luandersonarlindo/IrrigacaoInteligente/irrigation_controller.h

#pragma once

// ============================================================
//  irrigation_controller.h — Controlador de Irrigação
//
//  Fase 2: GPIO reais, trigger HIGH, timeout de segurança.
//
//  Responsabilidade: acionar/desacionar relés e monitorar
//  tempo de segurança no modo manual.
//  NÃO conhece menu, NÃO conhece display.
// ============================================================

#include <Arduino.h>
#include "Config.h"
#include "runtime_config_manager.h"

enum class EstadoValvula
{
    FECHADA,
    ABERTA
};

// Conta quantos bits (setores) estão marcados em uma máscara. Usado por
// DisplayManager e WebApManager para resumir quantos setores estão em cada
// estado (abertos, em agenda, selecionados etc.).
inline int contarBitsSetor(uint16_t mask)
{
    int total = 0;
    for (int i = 0; i < NUM_VALVULAS; i++)
    {
        if (mask & (1U << i))
            total++;
    }
    return total;
}

class IrrigationController
{
public:
    explicit IrrigationController(RuntimeConfigManager &config);

    void begin();

    // Toggle: se fechada abre, se aberta fecha
    // Retorna o novo estado após o toggle
    EstadoValvula toggleValvula(int indice);

    // Aciona por agendamento por um período em minutos.
    // Se a válvula já estiver aberta, preserva o maior tempo restante.
    void iniciarAgendamento(int indice, uint16_t duracaoMin);

    // Fecha uma válvula específica
    void fecharValvula(int indice);

    // Fecha todas — segurança garantida
    void fecharTodas();

    // Retorna o estado atual de uma válvula
    EstadoValvula estadoValvula(int indice) const;

    // Retorna true se alguma válvula está aberta
    bool algumAbertas() const;

    // Origem da válvula aberta: false = manual, true = agendamento automático.
    bool valvulaEmAgendamento(int indice) const;

    // Quantas válvulas estão abertas por origem manual (não-agendamento).
    int contarAbertasManual() const;

    // Quantas válvulas estão abertas por origem de agendamento automático.
    int contarAbertasAutomatico() const;

    // Tempo restante até o fechamento automático (0 se fechada ou vencida)
    unsigned long tempoRestanteMs(int indice) const;

    // Deve ser chamado no loop() — verifica timeout de segurança
    // Retorna índice da válvula que foi fechada por timeout, -1 se nenhuma
    int atualizar();

private:
    RuntimeConfigManager &_config;
    EstadoValvula _estados[NUM_VALVULAS];
    unsigned long _tempoAbertura[NUM_VALVULAS]; // millis() de quando abriu
    unsigned long _deadlineFechamento[NUM_VALVULAS];
    bool _origemManual[NUM_VALVULAS];

    // Mapa de pinos — índice 0 = canal 1
    static const uint8_t _pinos[NUM_VALVULAS];

    void abrirValvula(int indice);
    void atualizarDeadline(int indice, unsigned long novoDeadline, bool origemManual);
    bool indiceValido(int indice) const;
};
