luandersonarlindo/IrrigacaoInteligente/display_manager.h

#pragma once

// ============================================================
//  display_manager.h — Gerenciador de Display
//
//  Responsabilidade: decidir O QUE mostrar no display.
//  Consulta o MenuController para saber o estado atual.
//  Usa o DisplayDriverOled para saber COMO mostrar.
//
//  Separação clara:
//    Driver  = como desenhar (hardware)
//    Manager = o que desenhar (lógica de UI)
// ============================================================

#include <Arduino.h>
#include "Config.h"
#include "display_driver_oled.h"
#include "menu_controller.h"
#include "menu_cards.h"
#include "rtc_driver_ds3231.h"
#include "dht11_driver.h"
#include "irrigation_controller.h"
#include "web_ap_manager.h"

class DisplayManager
{
public:
    DisplayManager(DisplayDriverOled &display,
                   MenuController &menu,
                   RtcDriverDs3231 &rtc,
                   IrrigationController &irrigacao,
                   WebApManager &webAp,
                   Dht11Driver &dht11);

    void begin();

    // Estado da execução sequencial de agenda (lotes + intervalo).
    void atualizarEstadoAgendaSequencial(bool ativa,
                                         bool aguardandoIntervalo,
                                         uint8_t setoresEmLote,
                                         uint8_t setoresPendentes,
                                         uint16_t setoresLoteMask,
                                         uint16_t setoresPendentesMask);

    // Deve ser chamado no loop() — renderiza a tela correta
    void atualizar();

private:
    DisplayDriverOled &_display;
    MenuController &_menu;
    RtcDriverDs3231 &_rtc;
    Dht11Driver &_dht11;
    IrrigationController &_irrigacao;
    WebApManager &_webAp;

    // Telas
    void desenharMenuPrincipal();
    void desenharTelaStatus();
    void desenharTelaSensores();
    void desenharTelaIrrigacao();
    void desenharTelaProgramar();
    void desenharTelaConfig();
    void desenharTelaWebServer();

    // Componentes reutilizáveis
    void desenharCabecalho(const char *titulo);
    void desenharCursor(int y);
    // Rodapé padrão: linha separadora em y=54 + texto de dica em y=56
    void desenharRodapeDica(const char *texto);
    // Par de botões SIM/NAO com destaque no selecionado (opcaoSelecionada: 0=SIM, 1=NAO)
    void desenharConfirmacaoSimNao(int opcaoSelecionada);
    // Cards empilhados (estilo Menu Principal) com contador "N/total" no rodapé,
    // usados pelos submenus de Configurações. iconeAtual é um bitmap 1bpp 28x28
    // (ex: ICON_CLOCK_28X28); a opção "Voltar" usa ICON_CORNER_UP_LEFT_28X28.
    void desenharCardsOpcao(const char *rotuloAtual, const char *rotuloProximo,
                             const uint8_t *iconeAtual, int posicaoAtual, int totalOpcoes);

    // Controle de atualização (evita redesenho desnecessário)
    unsigned long _ultimaAtualizacao;
    static const unsigned long INTERVALO_ATUALIZACAO_MS = 200;

    // Apaga o painel após inatividade no dashboard (Status, sem menu ativo)
    bool _displayLigado;
    static const unsigned long DASHBOARD_TIMEOUT_MS = 60000;

    // Estado operacional da agenda automática sequencial
    bool _agendaExecucaoAtiva;
    bool _agendaAguardandoIntervalo;
    uint8_t _agendaSetoresEmLote;
    uint8_t _agendaSetoresPendentes;
    uint16_t _agendaSetoresLoteMask;
    uint16_t _agendaSetoresPendentesMask;
};
