luandersonarlindo/IrrigacaoInteligente/(commit log)

2026-04-11 Atualiza README.md com descrição detalhada do projeto, objetivos, arquitetura, funcionalidades e instruções de uso.
2026-04-11 Adiciona suporte à configuração de data e hora no MenuController e atualiza dependências no IrrigacaoInteligente
2026-04-11 Adiciona gerenciador de configuração em tempo de execução, integrando novas funcionalidades ao MenuController, ScheduleManager e IrrigationController. Atualiza a lógica de configuração e armazenament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
2026-04-11 Adiciona funcionalidade de restauração de configurações padrão e implementa teste de válvulas no MenuController. Atualiza o DisplayManager para exibir novas opções de configuração e ajusta a lógica d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
2026-04-11 Adiciona opção de voltar no MenuController e atualiza lógica de navegação. Melhora exibição no DisplayManager para incluir item Voltar e ajusta lógica de timeout.
2026-04-11 Atualiza README.md e guia didático com informações sobre o sistema de irrigação, arquitetura, fluxo de execução e mapeamento de pinos. Melhora a clareza e a organização do conteúdo.
2026-04-11 Adiciona opção "Voltar" ao submenu de programação e ajusta a lógica de navegação no MenuController. Atualiza o DisplayManager para exibir corretamente as opções de setores e a nova opção de voltar.
2026-04-12 feat: Implementar novos ícones de status e atualizar a tela de status
    - Adicionadas funções para desenhar ícones de status de irrigação, válvula, agenda e relógio no display.
    - Atualizada a função `desenharTelaStatus` para incluir informações sobre o estado da irrigação e a próxima agenda.
    - Implementada a lógica para determinar se uma válvula está em agendamento automático.
    - Adicionadas variáveis de estado para gerenciar a execução da agenda sequencial.
    - Atualizada a classe `MenuController` para incluir a verificação de eventos de exclusão de agenda.
    - Implementada a função `obterProximaExecucao` na classe `ScheduleManager` para localizar a próxima execução v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
2026-04-12 Atualiza formatação da tabela de mapeamento de pinos no README.md para melhor legibilidade.
2026-04-12 refactor: altera tipo de _ultimaChaveMinuto para int32_t e ajusta lógica de execução de agendas
2026-04-12 refactor: desabilita mensagens de debug no monitor serial e ajusta formatação de textos no WebApManager feat: adiciona ícone de Wi-Fi e atualiza lógica de navegação no MenuController
2026-04-12 refactor: reorganiza seções do README.md para melhor clareza e adiciona instruções de configuração rápida
2026-04-12 feat: adiciona ícones para o dashboard da irrigação e corrige formatação do HTML
2026-04-12 feat: adiciona suporte à paginação manual no WebServer e melhora a exibição de informações
2026-04-13 refactor: adiciona emojis para melhorar a legibilidade e organização do README.md, FASE5_CONTRATO_TECNICO.md e GUIA_DIDATICO_PROJETO.md
2026-04-13 feat: atualiza credenciais de Wi-Fi para nova rede
2026-04-16 Add event logging functionality to web_ap_manager
    - Introduced a new structure `EventoSistema` to store event details.
    - Added a maximum event history size constant `MAX_HISTORICO_EVENTOS`.
    - Implemented member variables for managing event history, including count and head index.
    - Added methods for initializing monitoring, updating event history, registering events, sending alerts, and clearing event history.
    - Included utility functions for counting open valves and escaping JSON strings.
2026-04-17 feat: Implementa painel de notificações no WebApManager
2026-04-18 feat: atualiza datas de revisão e adiciona novas funcionalidades ao contrato técnico e guias didáticos
2026-04-18 feat: adiciona suporte a configurações privadas e otimiza gerenciamento de agenda
2026-04-19 feat: adiciona suporte a mDNS para acesso ao sistema via hostname
2026-04-19 feat: adiciona suporte a WebSocket para comunicação em tempo real
2026-04-19 feat: adiciona badge de status para WebSocket com atualização dinâmica
2026-05-07 feat: adiciona suporte ao sensor DHT11 com leitura de temperatura e umidade
2026-07-15 feat(test): configure native PlatformIO test harness
    Task 1.1: Configurar ambiente PlatformIO nativo para testes
    TDD: RED > GREEN > REFACTOR complete
2026-07-15 test(schedule): extract and cover agenda validation rules
    Task 1.2: Isolar e testar regras de validação de agenda
    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
2026-07-15 chore: close Phase 1 (Fundação de Testes)
2026-07-15 test(schedule): extract and cover version+CRC validation for NVS blocks
    Task 2.1: Testar validação de versão+CRC do banco de agendas
    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
2026-07-15 test(execution): extract and cover batch selection and duration-conflict rules
    Task 2.2: Testar motor de execução sequencial por lotes (escopo parcial:
    seleção de lote + regra de conflito de duração). Retomada de janela ativa
    com tempo remanescente adiada para Task 2.3 (maior escopo, ~150 linhas de
    aritmética de época em schedule_manager.cpp, sem toolchain ESP32 disponível
    neste ambiente para validar).
    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
2026-07-16 feat(display): add sensor history graph and fix structural review findings
    Adiciona mini-gráfico de temperatura (últimas ~4h) na tela Sensores,
    com buffer circular testado em SensorHistorico. Corrige bugs achados
    em revisão estrutural completa: escala do eixo X do gráfico, checagem
    de agenda já executada em obterProximaExecucao, e bounds check em
    SensorHistorico::obter. Elimina duplicação de código (contagem de
    válvulas, popcount de bitmask, desenho de rodapé) e extrai a máquina
    de estados de execução de agenda do main.ino para AgendaExecutor
    dedicado, usando bitmask em vez de bool[8].
    [Config.h, IrrigacaoInteligente.ino, agenda_executor.cpp, agenda_executor.h, dht11_driver.cpp, dht11_driver.h, display_manager.cpp, display_manager.h]
2026-07-16 feat(display): redesign menu principal as stacked cards
    [display_manager.cpp, display_manager.h]
2026-07-16 fix(display): stop selected menu label from overflowing into OK arrow
    desenharMenuPrincipal() drew the selected item's label with
    desenharTextoGrande (10px/char, u8g2_font_10x20_tf) starting at x=40,
    which overflows the 128px display or collides with the OK arrow at
    x=118 for every menu item (e.g. "Irrigar Agora"/"Configuracoes" need
    130px, "Programar"/"WEBSERVER" need 90px, "Sensores" needs 80px).
    Switch to desenharTexto (6px/char, u8g2_font_6x10_tf), matching the
    font already used for the bottom card and most other screens. At
    6px/char the longest labels (13 chars) need exactly 78px, ending at
    x=118 with zero overlap. Adjusted the y-offset from cardSelY+8 to
    cardSelY+12 to keep the shorte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
    [display_manager.cpp]
2026-07-16 feat(display): apply stacked-cards style to Config submenus
    Extends the Pirx-style 2-card layout (selected item large + next item
    dimmed, circular wrap via MenuCards::proximoIndice) from Menu Principal
    to the 3 Config submenus (MENU, SUBMENU_RELOGIO, SUBMENU_SISTEMA),
    replacing the old 4-line sliding window.
    New DisplayManager::desenharCardsOpcao helper adds a "N/total" counter
    in the footer, since these submenus have up to 8 options (vs 5 fixed
    in Menu Principal) and lose the at-a-glance list depth the sliding
    window gave. Icons stay at their existing 8x8 size (redrawing at 32x32
    like Menu Principal was out of scope).
    [display_manager.cpp, display_manager.h]
2026-07-16 fix(display): remove header and enlarge icons on Config cards
    Hardware photos showed the "CONFIGURACOES"/"CONFIG > RELOGIO"/
    "CONFIG > SISTEMA" header overlapping the card border, and the 8x8
    icons were nearly illegible at that size.
    Removed desenharCabecalho() from the 3 option-card blocks (feedback
    animation screens keep their header, untouched). Replaced the 8x8
    icons with 28x28 1bpp bitmaps rasterized from real Lucide icons
    (lucide.dev, ISC license) via unpkg + @resvg/resvg-js, matching the
    icon scale used on Menu Principal. desenharCardsOpcao now takes a
    const uint8_t* bitmap instead of an int index; desenharIconeOuVoltar
    is gone since "Voltar" is now just the corner-up-left bitmap lik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
    [display_manager.cpp, display_manager.h]
2026-07-16 feat(display): extend Lucide icon cards to Editar Agenda, drop feedback animations
    Migrate EtapaProgramacao::SUBMENU_AGENDA (Programar > Editar Agenda) to
    the same desenharCardsOpcao stacked-card pattern already used by the
    Config submenus, reusing the existing Lucide 28x28 icon set. The old
    8x8 desenharIconeSubmenu (only caller left) is removed.
    Replace the frame-based feedback animations (check48/lixeira48, ~110
    lines of per-tick geometry) with a single desenharFeedbackIcone helper
    that shows a static 28x28 Lucide icon for a fixed 1200ms instead of
    animating over ~2s. Used across all 4 feedback points (Programar
    saved/deleted, Config saved/cleared/restored) — less flash, simpler
    logic,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
    [display_manager.cpp, menu_controller.cpp]
2026-07-16 feat(display): redesign Status dashboard header with WiFi indicator
    Remove the "ON N/N" text + tap icon from the top-right corner of the
    dashboard header — it was redundant with the sector status line right
    below it (e.g. "MANUAL S1/8"), and freed up space for something more
    useful.
    Replace it with a WiFi connectivity icon (Lucide wifi/wifi-off, 12x12)
    driven by the already-existing WebApManager::staConectada() — no new
    API needed. Only 2 states (connected/not), no RSSI, since signal
    strength isn't reliably meaningful on this ESP32's combined AP+STA
    setup.
    Also swap the small hand-drawn clock and next-agenda icons (10x10)
    for their Lucide equivalents (clock, calendar-clock) at 14x14, t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
    [display_manager.cpp]
2026-07-16 fix(display): fine-tune Status dashboard after hardware validation
    Three adjustments based on physical display photos:
    - Swap the WiFi icon from "wifi" (4 concentric arcs) to Lucide's
    "wifi-high" (3 arcs) — the extra outer arc was cluttered and hard
    to read at 12x12.
    - Drop the "S%d/%d" sector count from the MANUAL/AUTO/ATIVO status
    line (now just "MANUAL", "AUTO", "MANUAL + AUTO", "ATIVO") — the
    count is already redundant with the per-sector web dashboard.
    - Remove the "Gire para abrir menu" footer and expand the "Próxima
    Agenda" box from 20px to 35px tall (down to the display's exact
    bottom edge), giving the calendar icon and its two text lines
    room to breathe instead o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
    [display_manager.cpp]
2026-07-17 fix(display): revert WiFi icon and add dashboard idle screensaver
    Revert the WiFi icon back to the original 4-arc "wifi" glyph — the
    prior swap to "wifi-high" (3 arcs) had it backwards from what was
    actually intended on hardware.
    Add a screensaver for the dashboard: after 60s with no encoder
    interaction while parked on the Status screen (not navigating any
    menu), the OLED panel powers down via U8g2's setPowerSave — an I2C
    command, not a physical power cut — and wakes back up on the next
    rotation or click.
    MenuController gets a new msDesdeUltimaInteracao() getter that
    reuses the existing _ultimoEventoMenuMs timestamp (already tracked
    for the pre-existing 30s menu-inactivity timeout),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
    [display_driver_oled.cpp, display_driver_oled.h, display_manager.cpp, display_manager.h, menu_controller.cpp, menu_controller.h]
2026-07-17 fix(rtc): stop overwriting time with build timestamp, sync via NTP instead
    The DS3231's Oscillator Stop Flag can trip on boot from momentary
    electrical noise even with a good backup battery — it doesn't
    necessarily mean the RTC actually lost its time. RtcDriverDs3231::begin()
    was treating that flag as gospel and overwriting the RTC with
    __DATE__/__TIME__ (the firmware's compile time, not real time)
    whenever it fired. That's what was resetting the user's correctly-set
    clock on every reboot: the flag tripped, the RTC got clobbered with a
    stale compile-time timestamp.
    Removed that fallback — a lostPower() flag now just logs a warning and
    leaves the RTC alone. In its place, WebApManager gai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
    [rtc_driver_ds3231.cpp, web_ap_manager.h]
2026-07-23 fix(web): migrate WebServer to ESPAsyncWebServer, fix firmware freeze on web access
    WebServer sincrono bloqueava o loop principal (display/encoder/irrigacao)
    ao enviar o HTML da pagina (~35-40KB), travando o ESP32 ao acessar o
    dashboard web — agravado por mDNS. Migrado WebServer+WebSocketsServer
    para ESPAsyncWebServer+AsyncWebSocket (ESP32Async fork, compativel com
    mbedTLS 3.x do core ESP32 3.3.10). WebSocket agora embutido no mesmo
    servidor (porta 80, path /ws) em vez de porta 81 separada.
    Validado em hardware: acesso repetido por IP e mDNS sem travar, todas
    as funcionalidades web (valvulas, agendas, RTC, config runtime,
    WebSocket) operando normalmente.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
    [Config.h, web_ap_manager.h]
